janmederly/rp6/doc/poster-fvat-2016/Bibliografia.docx

# Bibliografia

1. Struth, W. Bezpečnosť, komfort a agilita – asistenčné systémy pre vodiča od firmy Bosch. [Online] 6 2009. [Dátum: 27. 4. 2016.]

2. Úmrtí při dopravních nehodách v Evropě. Wikipédia. [Online] [Dátum: 27. 4. 2016.]

3. BECEP. Nárast nehodovosti. [Online] 28. 10. 2014. [Dátum: 27. 4. 2016.]

4. Bezpečnostný vzduchový vankúš. Wikipédia. [Online] [Dátum: 27. 4. 2016.]

5. ABS (vozidlo). Wikipédia. [Online] [Dátum: 27. 4. 2016.]

6. Sajdl, J. ABS (Anti-lock Braking System). autolexicon.net. [Online] 28. 3. 2011. [Dátum: 27. 4. 2016.]

7. Klus, J. Snímače. [Online] [Dátum: 27. 4. 2016.] http://files.jozefklus.webnode.sk/200000173-

8. Volkswagen. Technický lexikón: Antiblokovací systém (ABS). [Online] [Dátum: 27. 4. 2016.]

9. Regulácia preklzovania. Wikipédia. [Online] [Dátum: 27. 4. 2016.]

10. Škoda Auto. Protipreklzový systém - ASR. [Online] [Dátum: 27. 4. 2016

11. Elektronický stabilizačný systém. Wikipédia. [Online] [Dátum: 27. 4. 2016.]

12. BECEP. ESP je jednoznačný pomocník! [Online] 23. 3. 2013. [Dátum: 27. 4. 2016.]

13. Sajdl, J. ESP (Electronic Stability Programme). autolexicon.net. [Online] 5. 4. 2011. [Dátum: 27. 4. 2016.]

14. Volkswagen. Technický lexikón: Elektronický stabilizačný program (ESP). [Online] [Dátum: 27. 4. 2016.]

15. Andrejčák, T. ESP je od novembra povinné. Autá sa bez neho predávať nesmú. auto.pravda.sk. [Online] 4. 11. 2014. [Dátum: 27. 4. 2016.]

16. Garaj, F. Renault Laguna 4Control skúša oklamať fyziku. [Online] 25. 10. 2011. [Dátum: 27. 4. 2016.]

17. Volkswagen. Brzdový asistent - v núdzi zastavíte rýchlejšie. [Online] [Dátum: 27. 4. 2016.]

18. Sajdl, J. Multikolízna brzda. autolexicon.net. [Online] 23. 5. 2015. [Dátum: 27. 4. 2016.]

19. Volkswagen. Side Assist "Plus". [Online] [Dátum: 27. 4. 2016.]

20. Volkswagen. Technický lexikón: Lane Assist. [Online] [Dátum: 27. 4. 2016.]

21. Volkswagen. Sign Assist. [Online] [Dátum: 27. 4. 2016.]

22. Volkswagen. Technický lexikón: Park Assist. [Online] [Dátum: 27. 4. 2016.]

23. Citroen. Asistent rozjazdu do kopca. [Online] [Dátum: 27. 4. 2016.]

24. Andrejčák, T. Monitorovanie tlaku pneumatík bude povinné. Aj na STK. auto.pravda.sk. [Online] 24. 10. 2014. [Dátum: 27. 4. 2016.]

25. Volkswagen. Technický lexikón: Dynamic Light Assist. [Online] [Dátum: 27. 4. 2016.]

26. Volkswagen. Technický lexikón: Dažďový senzor. [Online] [Dátum: 27. 4. 2016.]

27. Využití Bluetooth z mobilu, tabletu nebo PC k ovládání. Černý, M. 2, 2015, Praktická elektronika, Zv. XX (LXIV), s. 20-23. ISSN 1804-7173.

28. yhtomitsy. Add bluetooth to your Arduino project - Arduino+HC-06. Instructables. [Online] [Dátum: 28. 4. 2016.]

29. jsvester. Simple Arduino and HC-SR04 Example. Instructables. [Online] [Dátum: 27. 4. 2016.]

30. Božík, M. Ako naprogramovať Arduino bez predchádzajúcich znalostí. 2013.

31. Bears, Z. http://zacharybears.com/low-latency-raspberry-pi-video-streaming/. [Online] [Dátum: 27. 4. 2016.]

32. Mikrokontrolér. Wikipédia. [Online] [Dátum: 27. 4. 2016.]

33. Elecrow. Motor&Stepper Shield. [Online] [Dátum: 27. 4. 2016.]

34. Arduino. Arduino Language Reference. [Online] [Dátum: 27. 4. 2016.]
