janmederly/rp6/doc/prezentacia.pptx

## Slide 2


kamera

Android variant Free Icon

Ultrazvukový senzor vzdialenosti

Bluetooth + WiFi


## Slide 3

Motory

Ovládač motorov

Fotorezistor

Svetlá

WiFi

Kamera

Raspberry Pi

Arduino

Bluetooth

UZV senzor

Napájací systém

Baterky
