janmederly/rp6/doc/poster-fvat-2016/grafy.xlsx

Sheet: Meranie rýchlosti
Meranie | Rýchlosť meraná stopkami [m/s] | Rýchlosť meraná elektronicky [m/s]
1 | 0.567 | 0.543
2 | 0.567 | 0.537
3 | 0.556 | 0.567
4 | 0.563 | 0.546
5 | 0.554 | 0.544
Priemer 1-5 | 0.561 | 0.547
6 | 0.783 | 0.744
7 | 0.802 | 0.739
8 | 0.783 | 0.756
9 | 0.778 | 0.744
10 | 0.787 | 0.752
Priemer 6-10 | 0.787 | 0.747
 | Meranie | Rýchlosť meraná stopkami | Rýchlosť meraná elektronicky
 | 1 | 0.567 | 0.543
 | 2 | 0.567 | 0.537
 | 3 | 0.556 | 0.567
 | 4 | 0.563 | 0.546
 | 5 | 0.554 | 0.544
 | Priemer 1-5 | 0.561 | 0.547
 | 6 | 0.783 | 0.744
 | 7 | 0.802 | 0.739
 | 8 | 0.783 | 0.756
 | 9 | 0.778 | 0.744
 | 10 | 0.787 | 0.752
 | Priemer 6-10 | 0.787 | 0.747

Sheet: Prekážka - rýchlosti
Kedy zastať [cm] | Rýchlosť merania [ms] | Počet zastavení (z 6)
40 | 204 | 6
40 | 102 | 6
40 | 66 | 6
30 | 204 | 4
30 | 102 | 6
30 | 66 | 6
20 | 204 | 1
20 | 102 | 1
20 | 66 | 2
 | 66 | 102 | 204
20 cm | 2 | 1 | 1
30 cm | 6 | 6 | 4
40 cm | 6 | 6 | 6

Sheet: Prekážka - uhol
Uhol | Počet zastavení (z 5 pokusov)
0° | 5
30° | 5
45° | 0
60° | 0
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
