janmederly/rp6/(list of files, drawings)

Other design files:
schemy/meranie odporu.dsn
schemy/motory na vypinac.dsn
schemy/napajanie robota.dsn
schemy/robot arduino verzia bez svetiel.dsn
schemy/robot svetla.dsn
