janmederly/rp6/(commit log)

2016-04-24 Prva verzia
    [motory na vypinac.dsn, napajanie robota.dsn, robot arduino verzia bez svetiel.dsn]
2016-05-01 Vlastny prinos opisany. Schema pre svetla.
    [robot svetla.dsn]
2016-05-07 Prezentacia skoro hotova.
    [meranie odporu.dsn]
2016-09-26 El. meranie rychlosti
    [Rýchlosť pri zastavovaní, pokus 1.csv, Rýchlosť pri zastavovaní, pokus 1.xlsx, xyz.csv, xyz2.csv]
2016-11-09 Veci k posteru na finale FVAT 2016.
    [grafy.xlsx]
